Tympan/Tympan_Earpiece_Shield/README.md

# Tympan_Earpiece_Shield
Shield for Tympan Rev D that supports Tympan BTE Hardware
