Tympan/Tympan_Earpiece_Shield/Tympan_Earpiece_Shield_PCB_TOP.png

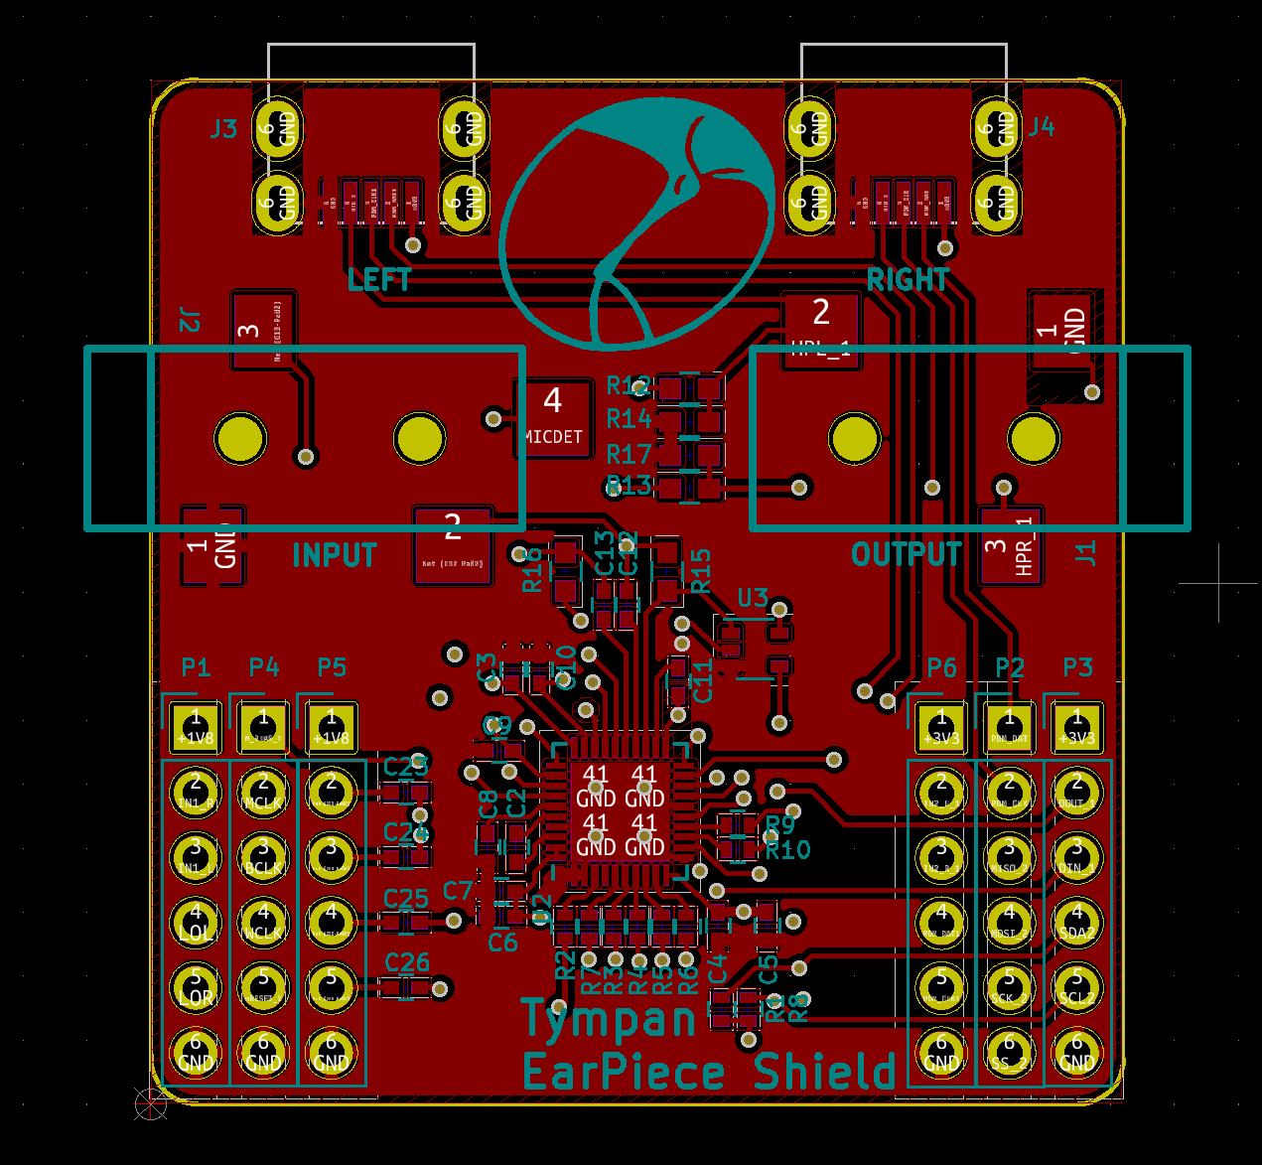
Tympan_Earpiece_Shield_PCB_TOP.png
