Tympan/Tympan_Earpiece_Shield/EarPieceShield_Enclosure/BOM_TYMPAN_EARPIECE_SHIELD_ENCLOSURE.xlsx

Enclosure for Earpiece Assy
BILL OF MATERIALS
CREATED: 05/06/2020
Line Item | Description | Manuf | P/N | QT
1 | ENCLOSURE ASSY |  |  | 1
2 | LIGHTPIPE_SQUARE_3MM_8MM LG | BIVAR | PLPQ3-8MM | 2
3 | LIGHTPIPE_2MM-SQUARE-FLAT_0125IN-LG | BIVAR | PLPQ2-125 | 1
4 | HEAT-SET INSERT_2-56_SHORT | MCMASTER | 94459A230 | 2
5 | PAN HEAD PHIL SCREW_2-56_0625LG_BLK_SS1 | MCMASTER | 91249A060 | 2
6 | RETAINING WASHER_#2-TO-M2-SCREW_0078 ID | MCMASTER | 91755A200 | 2
7 | DOWEL_PIN_0625 DIA_625LG_SS | MCMASTER | 97395A412 | 1
8 | BELT CLIP | THECLIP.COM | MCS-661BP | 1
9 | TRUSS-HEAD_PHIL_SCREW_6-32_0188 LG | MCMASTER | 91770A143 | 2
10 | O-RING_0094 WIDTH_SIZE-119 | MCMASTER | 1320N54 | 2
11 | HEAT-SET INSERT_6-32_SHORT_MMC_ | MCMASTER | 94459A280 | 2
12-OPTIONAL | STANDOFF_2-56_0250IN LG_NYLON | MCMASTER | 96110A090 | 2
13-OPTIONAL | SCREW_PHMS_2-56_0125IN LG_NYLON | MCMASTER | 93135A011 | 4
14 | MODS TO TYMPAN ASSY |  |  | 1
15 | HEADER_SOCKET_6X1_PITCH_0100 | SAMTECH | SLW-106-01-F-S2 | 4
16 | LIPO BATTERY_1200MAH | ADAFRUIT | 258 | 1
