Tympan/Tympan_Earpiece_Shield/EarPieceShield_Enclosure/TOP_EarpieceCaseDraft.stl

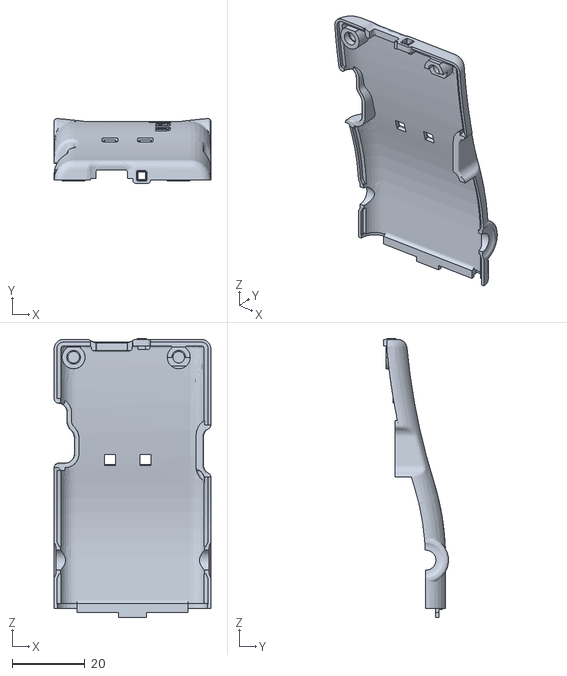
[picture p2: CAD file, 2020-04-01]
EarPieceShield_Enclosure/TOP_EarpieceCaseDraft.stl
43.2 x 17.9 x 77.0
