Tympan/Tympan_Earpiece_Shield/(list of files, cad)

Other CAD files:
EarPieceShield_Enclosure/2020-0324-03_TYMPAN-EARPIECE-SHIELD_TOP.STEP
