Tympan/Tympan_Earpiece_Shield/BETALayoutBuildLayers.pdf

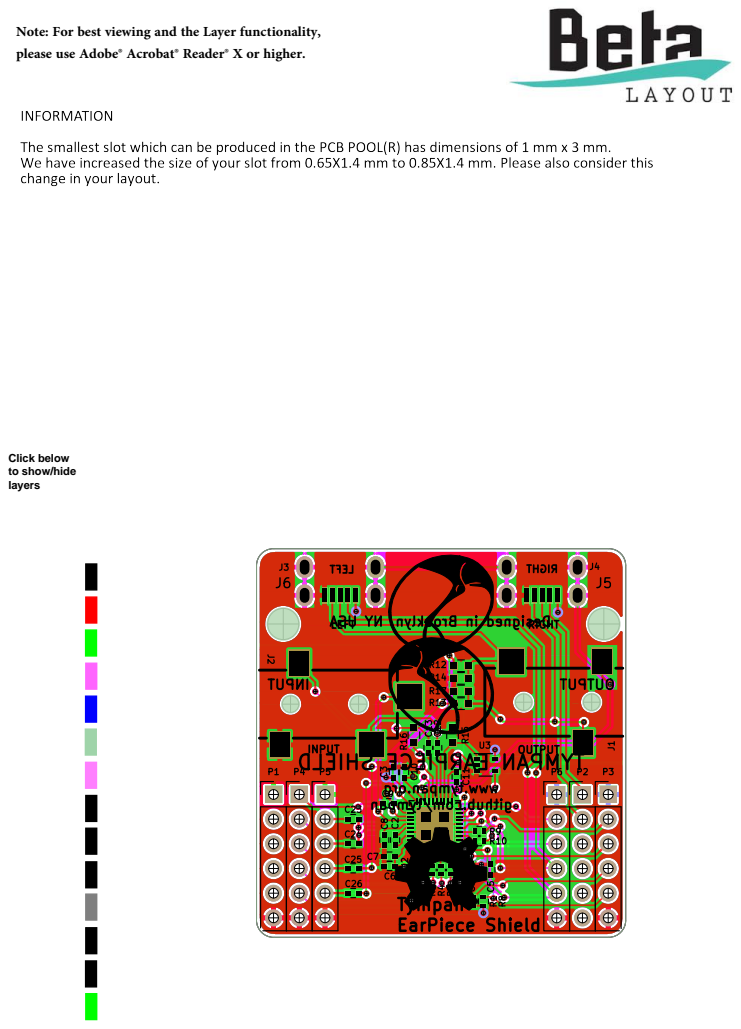
[picture p3: page 1]

Note: For best viewing and the Layer functionality,
please use Adobe® Acrobat® Reader® X or higher.
