Tympan/Tympan_Earpiece_Shield/Tympan_Earpiece_Shield_schematic.pdf

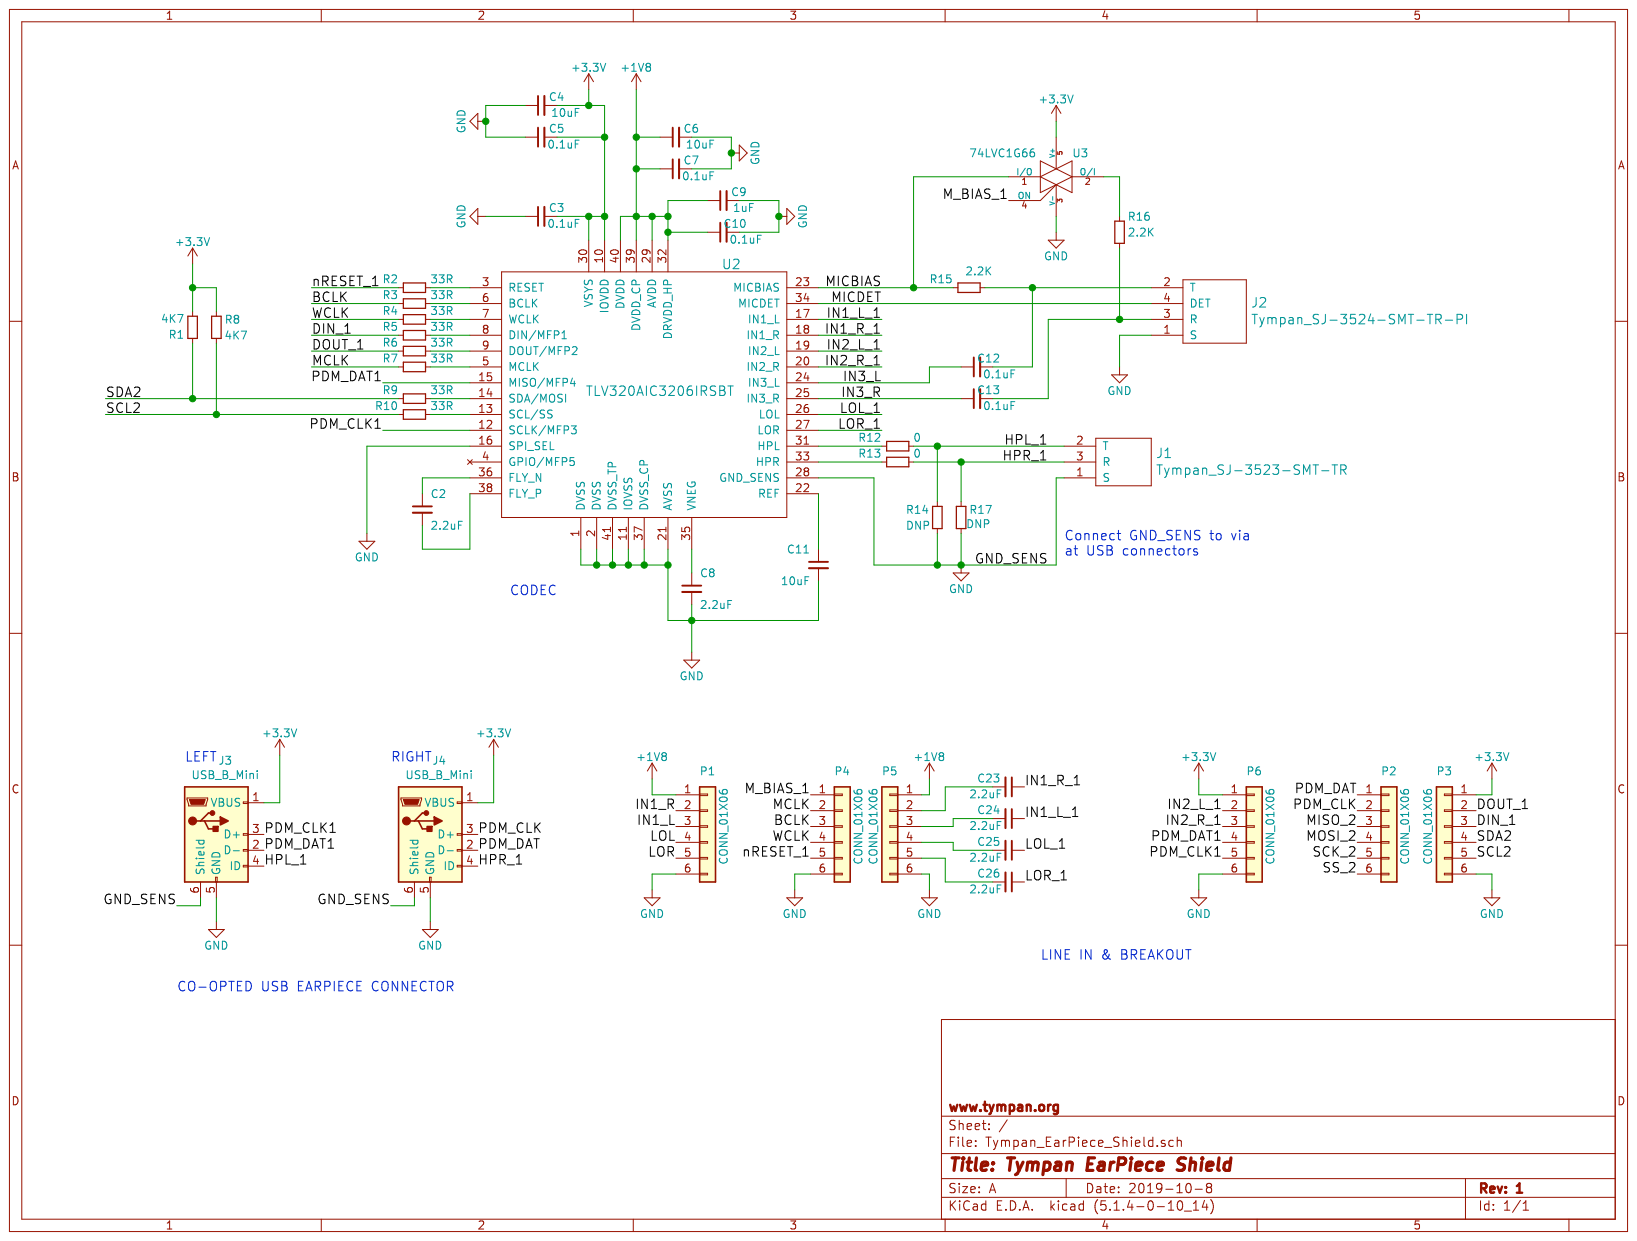
[picture p4: page 1]
