Tympan/Tympan_Earpiece_Shield/Tympan_Earpiece_Shield_PCB_TOP.pdf

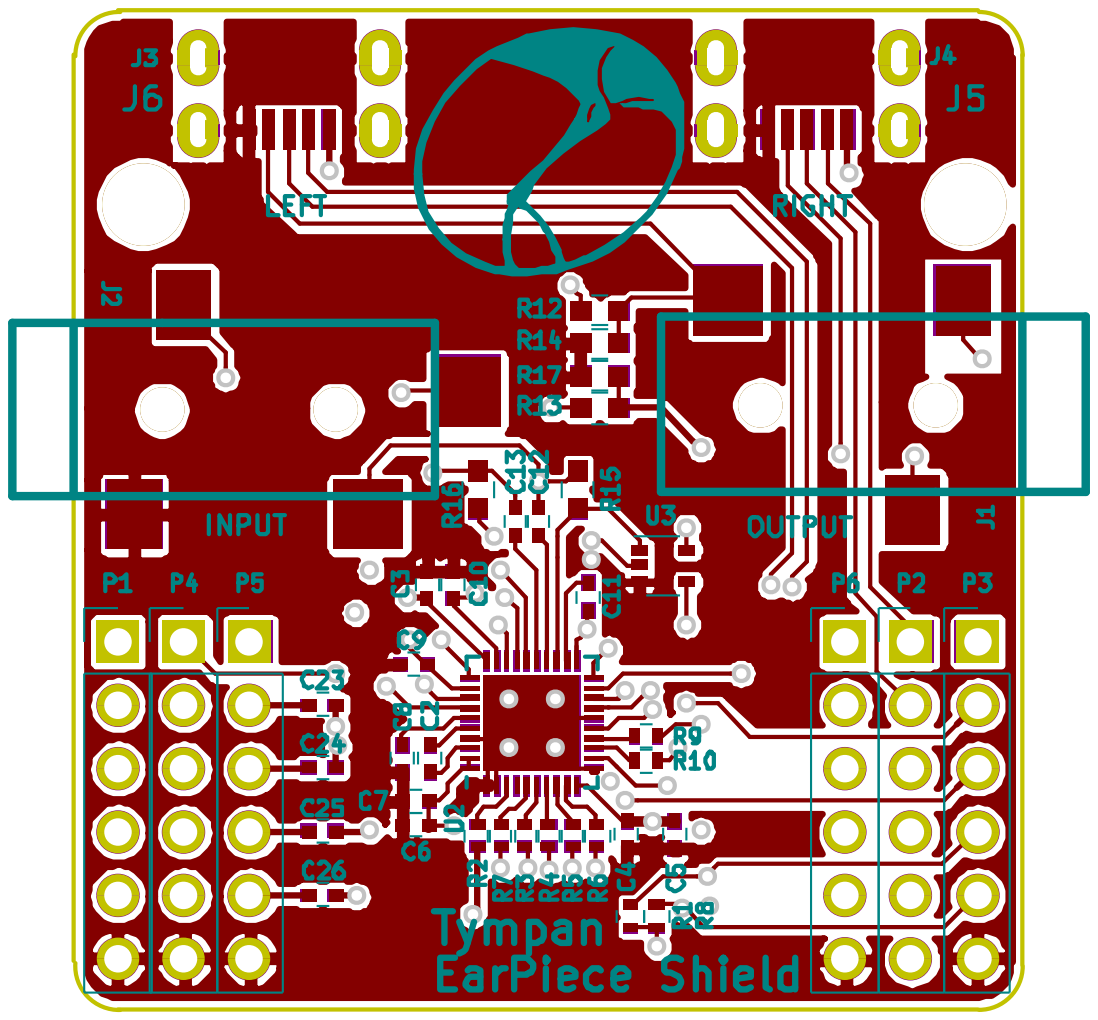
[picture p5: page 1]
