Tympan/Tympan_Earpiece_Shield/(threads)

Thread 1 (2020-02-19):

Future Enhancement: Swap PDM lines between AIC

erk1313, 2020-02-19:
Chip's preferred configuration is shown below.  To accomplish this, we will need to swap the PDM lines on the Earpiece Shield:

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

We will also need to swap the mic select lines on the earpiece flex circuit. Note that there is a typo in the existing schematic: Mic2 (front) was wired to VDD (although it says Select = GND) and Mic1 (Back) was wired to GND (although it says Select = VDD).  We want to actually swap the select lines, as shown by the red lines in the diagram below.
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

Also, we are consider swapping the location of the mini USB connectors so that when the Tympan is worn or placed on a table, the earpiece cables do not cross.  But we will consider this as the enclosure is designed.
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

eyuan-creare, 2020-06-22:
### Swap Left and Right Output Ports
Here is the required output configuration to match the labelled ports on the enclosure.  Notice the Left and Right output channels are swapped.  (Also note that with this configuration, the Left and Right HEADPHONE signals are swapped).
```
AudioConnection_F32           patchcord11(inputMixerL, 0, i2s_out, 1); //Tympan AIC, left output
AudioConnection_F32           patchcord12(inputMixerR, 0, i2s_out, 0); //Tympan AIC, right output
AudioConnection_F32           patchcord13(inputMixerL, 0, i2s_out, 3); //Shield AIC, left output
AudioConnection_F32           patchcord14(inputMixerR, 0, i2s_out, 2); //Shield AIC, right output
```

Here is the desired configuration:
```
AudioConnection_F32           patchcord11(inputMixerL, 0, i2s_out, 0); //Tympan AIC, left output
AudioConnection_F32           patchcord12(inputMixerR, 0, i2s_out, 1); //Tympan AIC, right output
AudioConnection_F32           patchcord13(inputMixerL, 0, i2s_out, 2); //Shield AIC, left output
AudioConnection_F32           patchcord14(inputMixerR, 0, i2s_out, 3); //Shield AIC, right output
```

To match the Left and Right labels on the enclosure, we will need to relabel the Left and Right ports on the Earpiece Shield PCB.  Then swap the L and R outputs to match.
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

eyuan-creare, 2020-06-22:
Refer to the following issue for correcting Front/Back mic configuration:
 https://github.com/Tympan/Earpiece_BTE-RIC_V1/issues/12

eyuan-creare, 2021-02-03:
@biomurph Hi Joel, were you able to update the schematics and pdf?  Are we ready to close this issue out?

biomurph, 2021-02-03:
@eyuan-creare
I am unclear about the issue and the extent of what needs changing.
Are you asking to change the connections all the way down to the metal between the USB Earpiece Connectors and the AIC chip? Would it be easier to just change the labeling on the enclosure?

eyuan-creare, 2021-02-03:
@biomurph my fault.  I confused this with the mislabeled PDM ports.  We can hold on this until we talk about a future board spin.

biomurph, 2021-07-07:
@eyuan-creare
bringing this up again in preparation for small production run to match BTE earpieces expected from WanShun.
Can you clarify the issue? Is this a schematics and PCB labeling issue?

eyuan-creare, 2021-07-07:
@chipaudette This issue pertains to the AIC channels. which are currently out of order.  Do you want to correct this for the new BTE's (and have hardware with a different L/R configuration) or leave them be?

chipaudette, 2021-07-07:
Leave them be as they are.  Let's not generate more churn right now.

biomurph, 2021-07-07:
@chipaudette
Okey Dokey.

This issue, and the one I closed about audio jack position, are the only ones that I have info on.
If there is anything else that came up on the Earpiece Shield, please LMK, as I am working on a short production run.
It looks like the turn is quick (2 weeks max) and I have sourced all the parts with plenty of buffer.

Thread 3 (2020-05-28):

Enclosure: Reset button

chipaudette, 2020-05-28:
@eyuan-creare, In a future revision of the enclosure, we need to add a hole so that we can poke down and hit the Tympan's reset button.

I've got a Tympan + Earpiece Shield that won't reprogram.  It looks like I have to open it up and press the reset button.

eyuan-creare, 2020-05-29:
Good idea.  For the existing units, I can drill out a small hole if you think Marc and Daniel would care.  For future units, I can add a flex section to the housing to create a button that rests on the reset.

-Eric

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

Thread 4 (2021-09-28):

Correct PDM Mic Routing for CLK and DATA

eyuan-creare, 2021-09-28:
There are two issues related to the routing of the PDM CLK and DATA lines.

### 1) Earpiece Shield Header to Tympan Rev-E

Here is the header for the Tympan Rev-E (Rev-v2).  Note that CLK is on P3.1 and DATA is on P3.2
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

Here is the header for the Earpiece Shield (Rev-1).  Note that CLK and DAT are switched
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

### 2) CLK and DATA signals on Second AIC

Here is the AIC on the Tympan Rev-E.  This is how the CLK and DATA signals should be connected.
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

Here is the AIC on the Earpiece Shield.  The CLK and DATA are reversed.
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

I believe this all comes down to TI's poor choice of using a SCLK pin for PDM Data.

@biomurph Can you correct the labels on the earpiece shield and highlight these correction in a revision table?

------
In summary, the PDM signals from both AICs are swapped.  The only reason the existing earpieces work is because the signals were swapped on the rigid earpiece as well.  This shows the correct signal routing for the Rigid PCB.

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

- I corrected the [Wiring Diagram_RIC Hearing Aid_Rev-D.pdf](https://github.com/Tympan/Earpiece_BTE-RIC_V1/tree/master/Electrical%20Design/Schematics_PDF) so that CLK and DATA are swapped.

- @biomurph Can you also change this on the [Rigid PCB](https://github.com/Tympan/Earpiece_BTE-RIC_V1/tree/master/Electrical%20Design/KICAD_BTE_RIGID)?

biomurph, 2025-09-17:
@eyuan-creare I am switching the CLK and DAT lines on the following components

- P2 header
- U2 AIC
- J3 USB Mini
- J4 USB Mini

That is the extent of the changes, correct?
