Tympan/Tympan_Earpiece_Shield/(commit log)

2019-10-30 Initial Commit!
    [Tympan_EarPiece_Shield.kicad_pcb, Tympan_EarPiece_Shield.sch]
2019-11-19 Added mounting holes
    [Tympan_EarPiece_Shield.kicad_pcb, Tympan_EarPiece_Shield.sch]
2019-11-19 Adjusted top copper pour. Updated top image
    [Tympan_EarPiece_Shield.kicad_pcb]
2019-12-01 Added pdf from prototype fab house
2020-02-21 Removed spaaces in file names
    [Tympan_EarPiece_Shield.kicad_pcb, Tympan_EarPiece_Shield.sch]
2020-03-26 commited first draft of Earpiece Enclosure STEP files
    [2020-0324-03_TYMPAN-EARPIECE-SHIELD_TOP.STEP]
2020-04-01 Added edrawing of entire enclosure assembly
2020-04-01 added STLs
    [TOP_EarpieceCaseDraft.stl]
2020-12-09 Moved bad silk reference out of the way
    [Tympan_EarPiece_Shield.kicad_pcb]
2021-06-24 Create BOM_TYMPAN_EARPIECE_SHIELD_ENCLOSURE.xlsx
    Added hardware for belt clip that was missing
    [BOM_TYMPAN_EARPIECE_SHIELD_ENCLOSURE.xlsx]
2021-07-07 Tidy silk
    [Tympan_EarPiece_Shield.kicad_pcb]
2021-07-12 Silk and audio jack positioning
    [Tympan_EarPiece_Shield.kicad_pcb]
2025-09-17 Fixed bug in PDM CLK and DAT lines
    CLK and DAT circuits were swapped.
    Swapping them back in all components fixes this bug and does not require any re-routing. This addresses #4
